VIP-LES/leos-efm-pcb/screenshots/3D.png

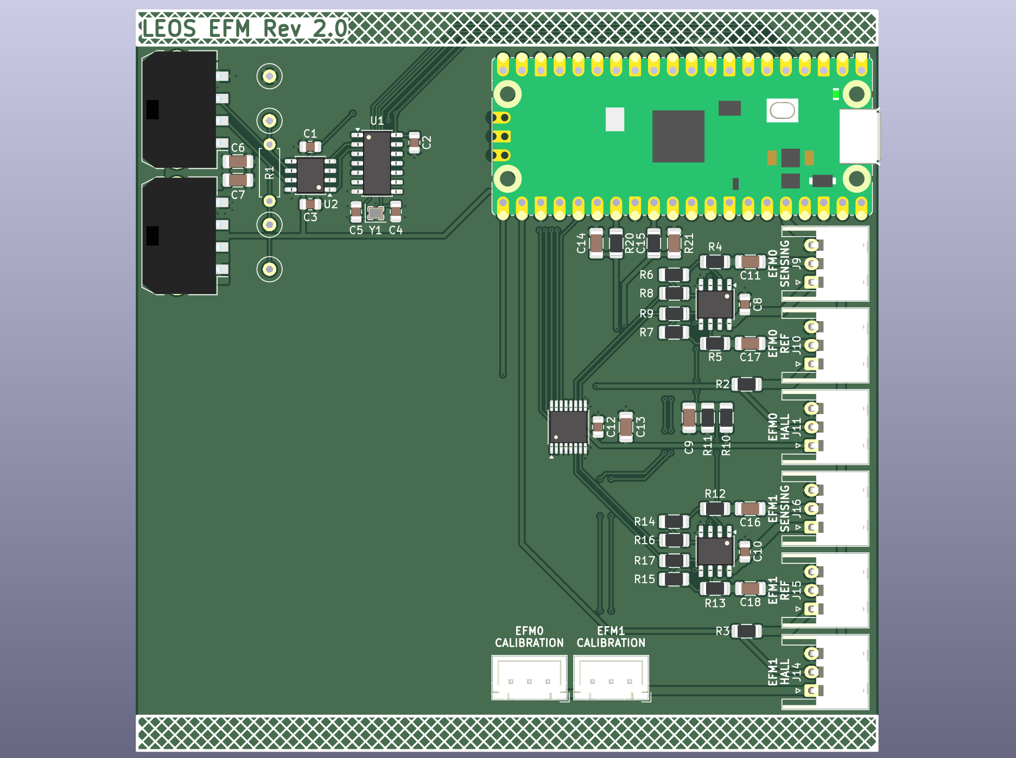
screenshots/3D.png
