VIP-LES/leos-efm-pcb/LEOS-efm.kicad_pcb

## KiCad design LEOS-efm.kicad_pcb (2026-10-29)

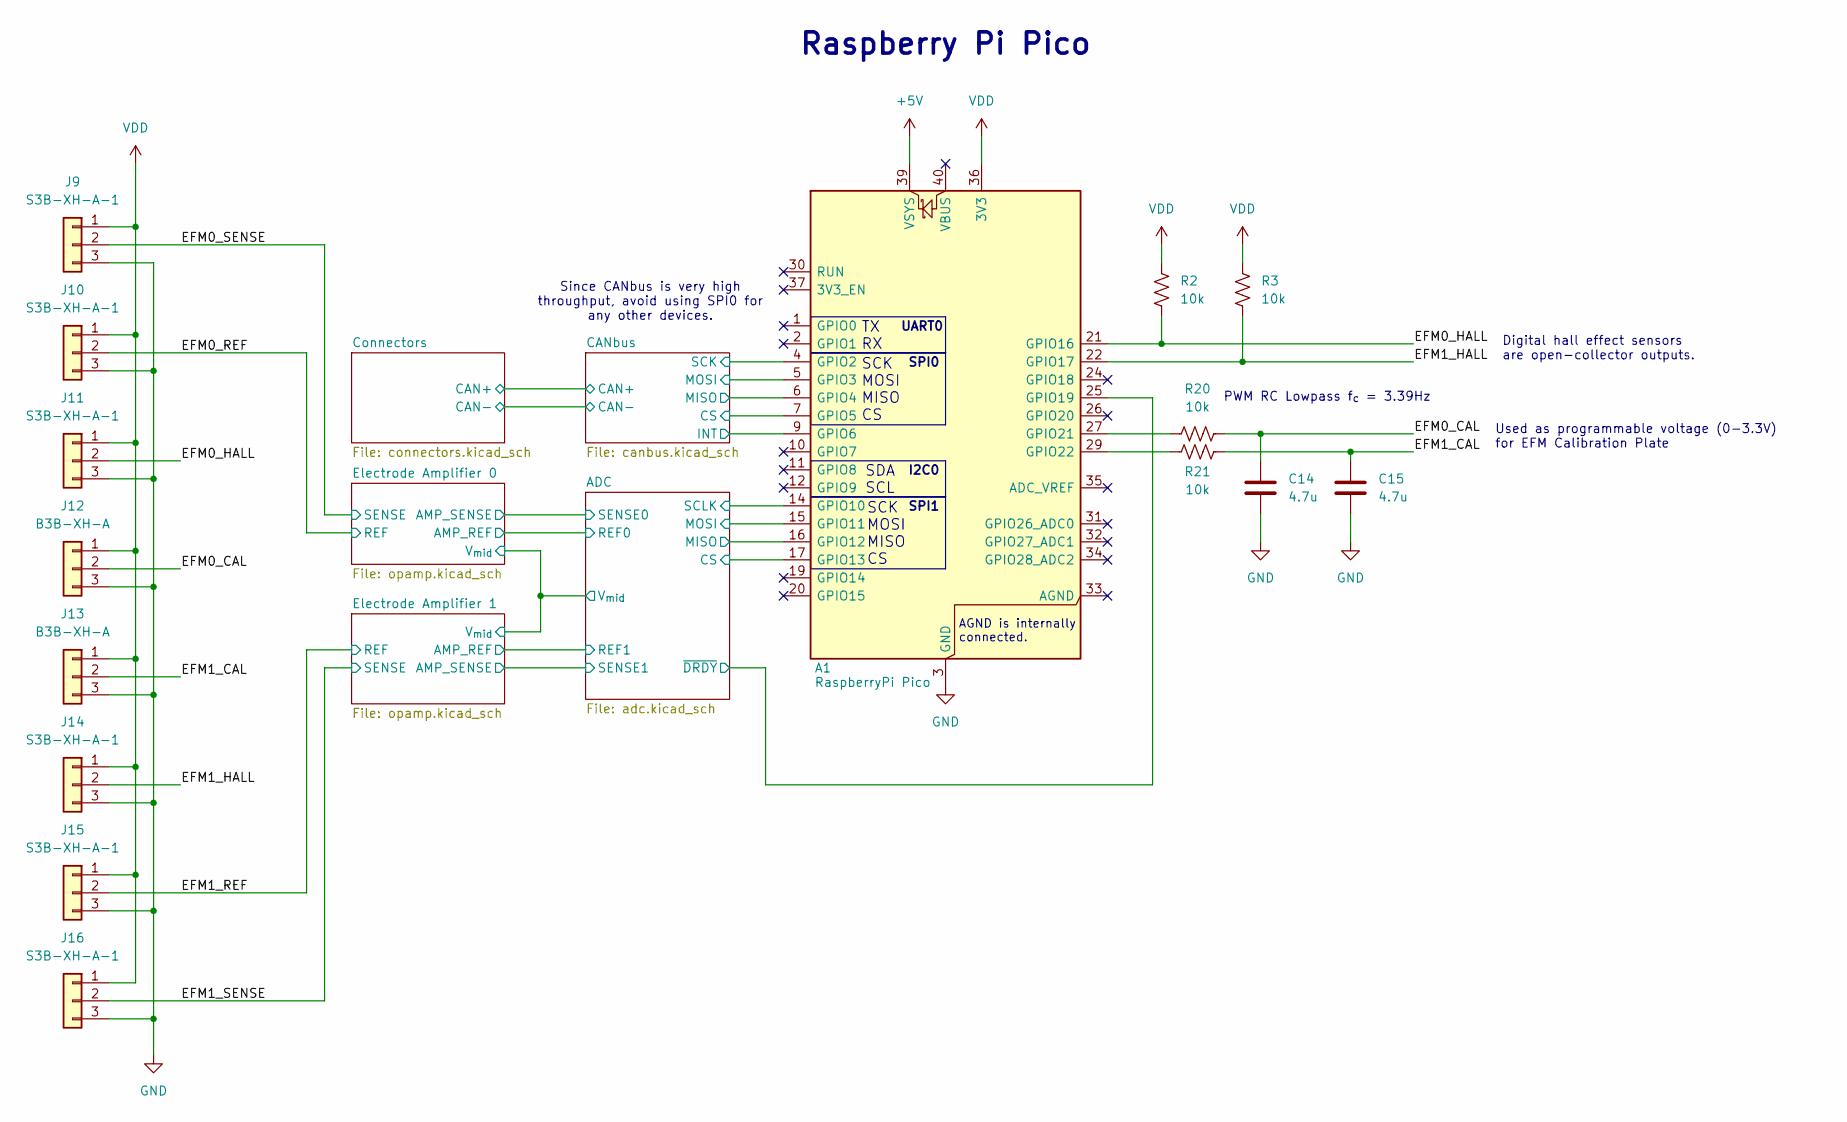
[picture p2: schematic LEOS-efm.kicad_sch, LEOS EFM]

Parts:
A1: RaspberryPi Pico; RaspberryPi_Pico_Common_Unspecified; MPN PIM724; Digikey 1778-PIM724-ND
C14, C15: 4.7u; C_1206_3216Metric; MPN CL31B475KBHNFNE; Digikey 1276-3179-1-ND
J9, J10, J11, J14, J15, J16: S3B-XH-A-1; JST_XH_S3B-XH-A-1_1x03_P2.50mm_Horizontal; MPN S3B-XH-A-1; Digikey 455-S3B-XH-A-1-ND
J12, J13: B3B-XH-A; JST_XH_B3B-XH-A_1x03_P2.50mm_Vertical; MPN B3B-XH-A; Digikey 455-2248-ND
R2, R3, R20, R21: 10k; R_1206_3216Metric

Connections:
+5V: A1.39 (VSYS); also elsewhere on the board
/ADC/CS: A1.17 (GPIO13); also elsewhere on the board
/ADC/MISO: A1.16 (GPIO12); also elsewhere on the board
/ADC/MOSI: A1.15 (GPIO11); also elsewhere on the board
/ADC/SCLK: A1.14 (GPIO10); also elsewhere on the board
/ADC/~DRDY: A1.25 (GPIO19); also elsewhere on the board
/CANbus/CS: A1.7 (GPIO5); also elsewhere on the board
/CANbus/INT: A1.9 (GPIO6); also elsewhere on the board
/CANbus/MISO: A1.6 (GPIO4); also elsewhere on the board
/CANbus/MOSI: A1.5 (GPIO3); also elsewhere on the board
/CANbus/SCK: A1.4 (GPIO2); also elsewhere on the board
/EFM0_CAL: C14.1, J12.2, R20.2
/EFM0_HALL: A1.21 (GPIO16), J11.2, R2.2
/EFM0_REF: J10.2; also elsewhere on the board
/EFM0_SENSE: J9.2; also elsewhere on the board
/EFM1_CAL: C15.1, J13.2, R21.2
/EFM1_HALL: A1.22 (GPIO17), J14.2, R3.2
/EFM1_REF: J15.2; also elsewhere on the board
/EFM1_SENSE: J16.2; also elsewhere on the board
GND: A1.3 (GND), A1.8 (GND), A1.13 (GND), A1.18 (GND), A1.23 (GND), A1.28 (GND), A1.38 (GND), C14.2, C15.2, J9.3, J10.3, J11.3, J12.3, J13.3, J14.3, J15.3, J16.3; also elsewhere on the board
unnamed: A1.27 (GPIO21), R20.1
unnamed: A1.29 (GPIO22), R21.1
VDD: A1.36 (3V3), J9.1, J10.1, J11.1, J12.1, J13.1, J14.1, J15.1, J16.1, R2.1, R3.1; also elsewhere on the board

Notes on the sheet:
PWM RC Lowpass f_{c} = 3.39Hz
SPI1
Raspberry Pi Pico
SCK MOSI MISO CS
Since CANbus is very high throughput, avoid using SPI0 for any other devices.
SPI0
SDA SCL
TX RX
UART0
Digital hall effect sensors are open-collector outputs.
I2C0
AGND is internally connected.
Used as programmable voltage (0-3.3V) for EFM Calibration Plate

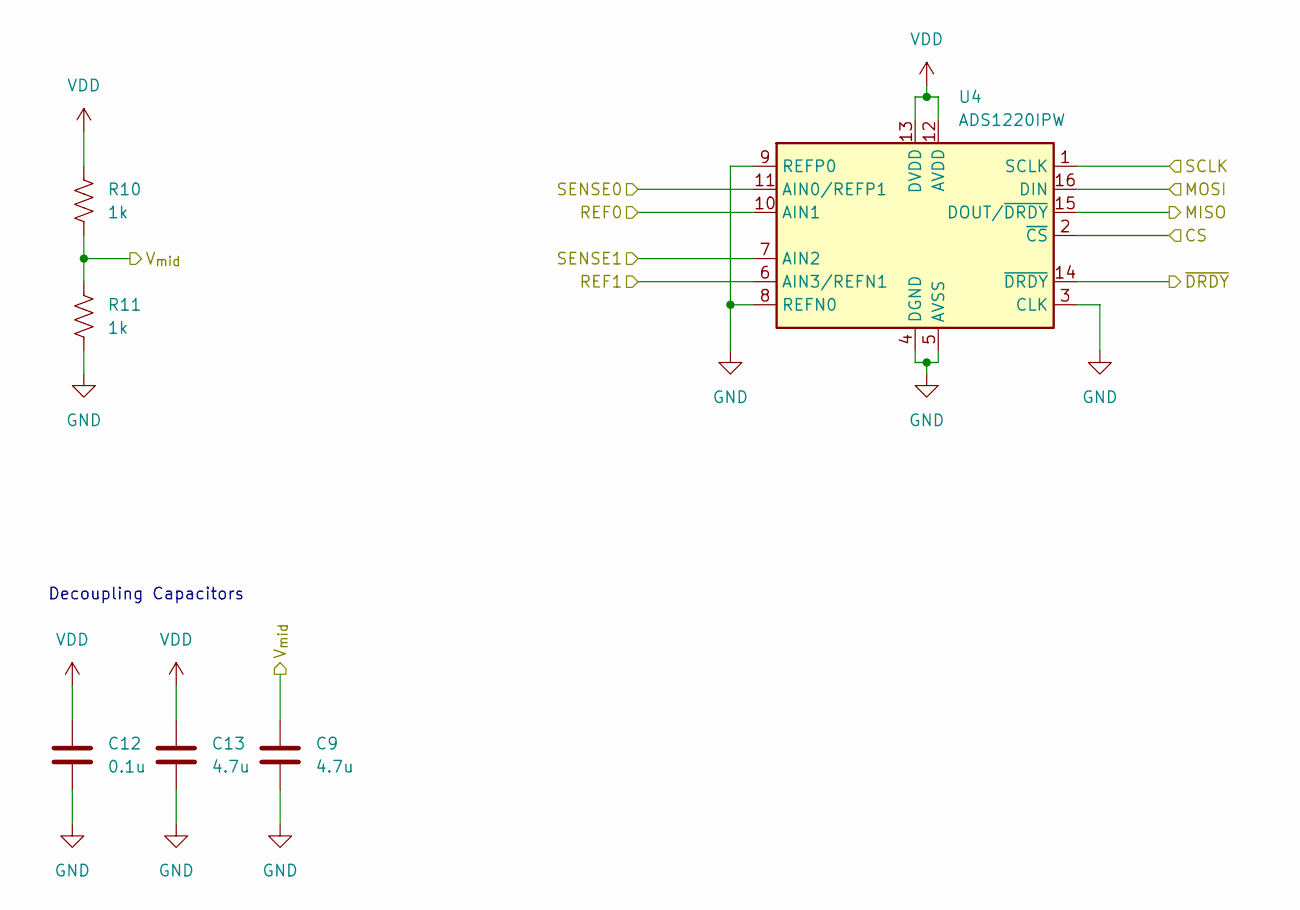
[picture p3: schematic adc.kicad_sch, Analog to Digital Conversion]

Parts:
C9, C13: 4.7u; C_1206_3216Metric; MPN CL31B475KBHNFNE; Digikey 1276-3179-1-ND
C12: 0.1u; C_0805_2012Metric; MPN CL21B104KBCNNNC; Digikey 1276-1003-1-ND
R10, R11: 1k; R_1206_3216Metric
U4: ADS1220IPW; TSSOP-16_4.4x5mm_P0.65mm; MPN ADS1220IPWR; Digikey 296-39851-1-ND

Connections:
/ADC/CS: U4.2 (~CS); also elsewhere on the board
/ADC/MISO: U4.15 (DOUT/~DRDY); also elsewhere on the board
/ADC/MOSI: U4.16 (DIN); also elsewhere on the board
/ADC/REF0: U4.10 (AIN1); also elsewhere on the board
/ADC/REF1: U4.6 (AIN3/REFN1); also elsewhere on the board
/ADC/SCLK: U4.1 (SCLK); also elsewhere on the board
/ADC/SENSE0: U4.11 (AIN0/REFP1); also elsewhere on the board
/ADC/SENSE1: U4.7 (AIN2); also elsewhere on the board
/ADC/V_{mid}: C9.1, R10.2, R11.1; also elsewhere on the board
/ADC/~DRDY: U4.14 (~DRDY); also elsewhere on the board
GND: C9.2, C12.2, C13.2, R11.2, U4.3 (CLK), U4.4 (DGND), U4.5 (AVSS), U4.8 (REFN0), U4.9 (REFP0); also elsewhere on the board
VDD: C12.1, C13.1, R10.1, U4.12 (AVDD), U4.13 (DVDD); also elsewhere on the board

Notes on the sheet:
Decoupling Capacitors

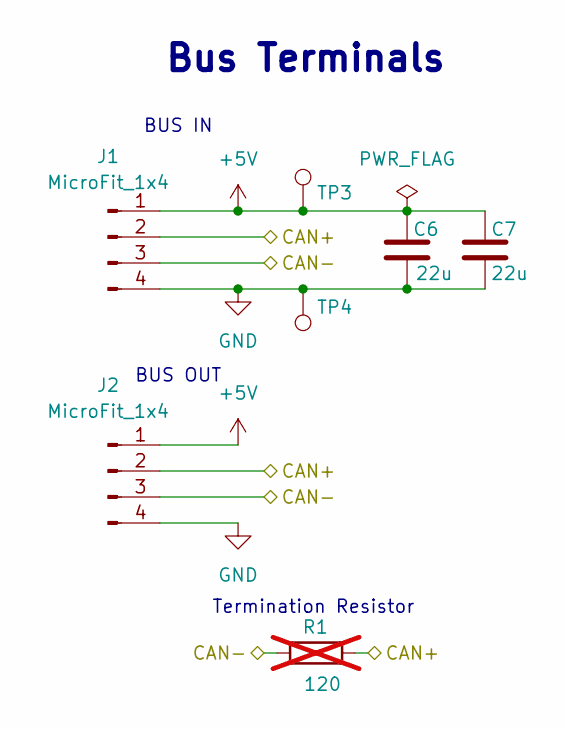
[picture p4: schematic connectors.kicad_sch, LEOS Connectors]

Parts:
C6, C7: 22u; C_1206_3216Metric; MPN CL31B226MPHNNNE; Digikey 1276-3148-1-ND
J1, J2: MicroFit_1x4; Molex_MicroFit3.0_43650-0410_1x04_Horizontal; MPN 0436500409; Digikey WM1882CT-ND
R1: 120; R_Axial_DIN0207_L6.3mm_D2.5mm_P7.62mm_Horizontal; MPN CF14JT120R; Digikey CF14JT120RCT-ND; not fitted
TP3: 5V Test Point; TestPoint_Loop_D2.60mm_Drill0.9mm_Beaded; MPN 5000; Digikey 36-5000-ND
TP4: GND Test Point; TestPoint_Loop_D2.60mm_Drill0.9mm_Beaded; MPN 5001; Digikey 36-5001-ND

Connections:
+5V: C6.1, C7.1, J1.1, J2.1, TP3.1 (1_1); also elsewhere on the board
/CANbus/CAN+: J1.2, J2.2, R1.2; also elsewhere on the board
/CANbus/CAN-: J1.3, J2.3, R1.1; also elsewhere on the board
GND: C6.2, C7.2, J1.4, J2.4, TP4.1 (1_1); also elsewhere on the board

Notes on the sheet:
BUS OUT
Bus Terminals
BUS IN
Termination Resistor

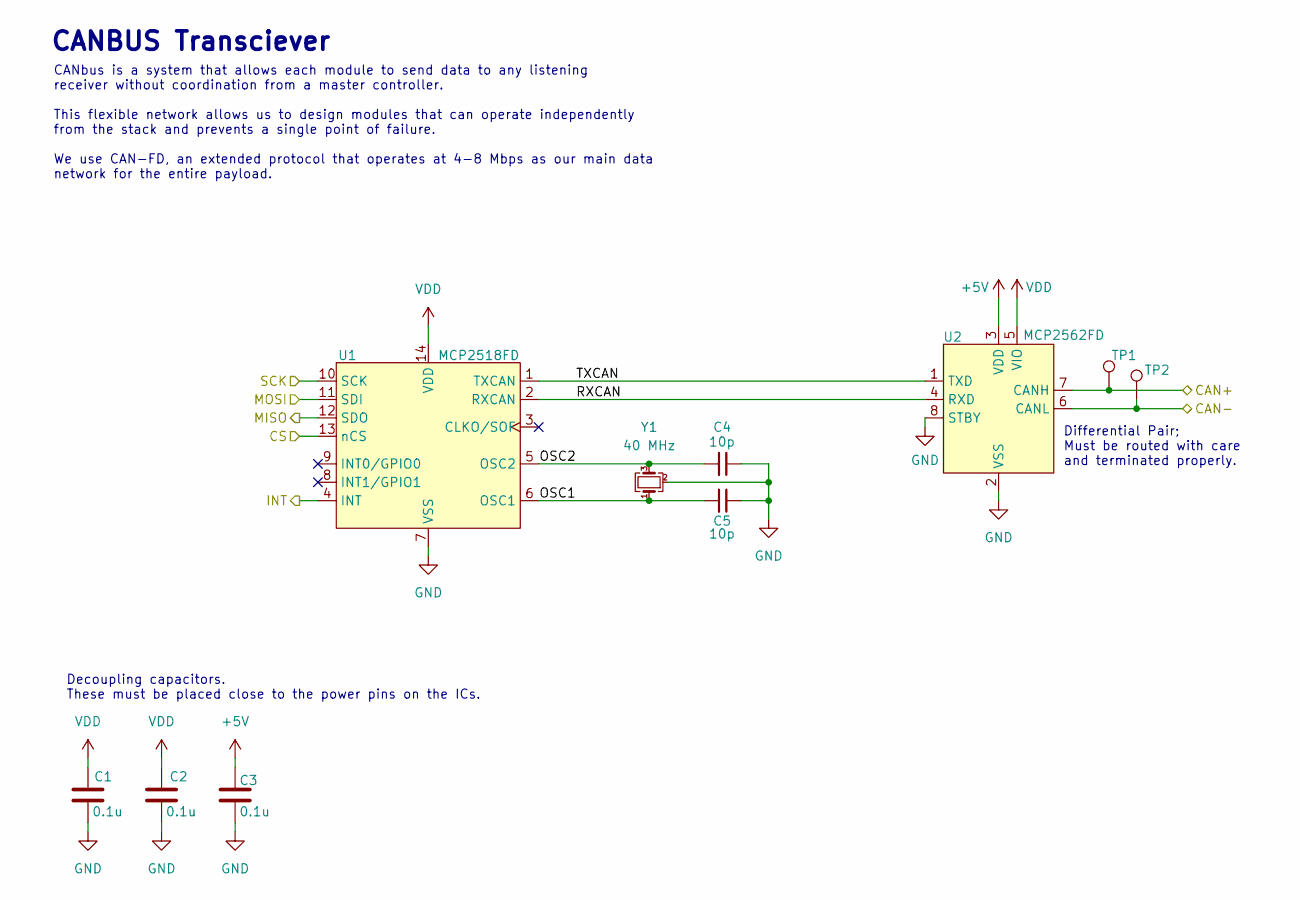
[picture p5: schematic canbus.kicad_sch, LEOS CANbus]

Parts:
C1, C2, C3: 0.1u; C_0805_2012Metric; MPN CL21B104KBCNNNC; Digikey 1276-1003-1-ND
C4, C5: 10p; C_0805_2012Metric; MPN CL21C100CBANNNC; Digikey 1276-2561-1-ND
TP1: CAN-H Test Point; TestPoint_Loop_D2.60mm_Drill0.9mm_Beaded; MPN 5004; Digikey 36-5004-ND
TP2: CAN-L Test Point; TestPoint_Loop_D2.60mm_Drill0.9mm_Beaded; MPN 5116; Digikey 36-5116-ND
U1: MCP2518FD; SOIC-14_3.9x8.7mm_P1.27mm; MPN MCP2518FDT-E/SL; LCSC C626758
U2: MCP2562FD; SOIC-8_3.9x4.9mm_P1.27mm; MPN MCP2562FDT-H/SN; LCSC C511335
Y1: 40 MHz; Crystal_SMD_2016-4Pin_2.0x1.6mm; MPN ECS-400-10-37B2-CKY-TR; Digikey 50-ECS-400-10-37B2-CKY-TRCT-ND

Connections:
+5V: C3.1, U2.3 (VDD); also elsewhere on the board
/CANbus/CAN+: TP1.1 (1_1), U2.7 (CANH); also elsewhere on the board
/CANbus/CAN-: TP2.1 (1_1), U2.6 (CANL); also elsewhere on the board
/CANbus/CS: U1.13 (nCS); also elsewhere on the board
/CANbus/INT: U1.4 (INT); also elsewhere on the board
/CANbus/MISO: U1.12 (SDO); also elsewhere on the board
/CANbus/MOSI: U1.11 (SDI); also elsewhere on the board
/CANbus/OSC1: C5.2, U1.6 (OSC1), Y1.1
/CANbus/OSC2: C4.2, U1.5 (OSC2), Y1.3
/CANbus/RXCAN: U1.2 (RXCAN), U2.4 (RXD)
/CANbus/SCK: U1.10 (SCK); also elsewhere on the board
/CANbus/TXCAN: U1.1 (TXCAN), U2.1 (TXD)
GND: C1.2, C2.2, C3.2, C4.1, C5.1, U1.7 (VSS), U2.2 (VSS), U2.8 (STBY), Y1.2 (G), Y1.4 (G); also elsewhere on the board
VDD: C1.1, C2.1, U1.14 (VDD), U2.5 (VIO); also elsewhere on the board

Notes on the sheet:
Differential Pair; Must be routed with care and terminated properly.
CANBUS Transciever
CANbus is a system that allows each module to send data to any listening receiver without coordination from a master controller. This flexible network allows us to design modules that can operate independently from the stack and prevents a single point of failure. We use CAN-FD, an extended protoco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
Decoupling capacitors. These must be placed close to the power pins on the ICs.

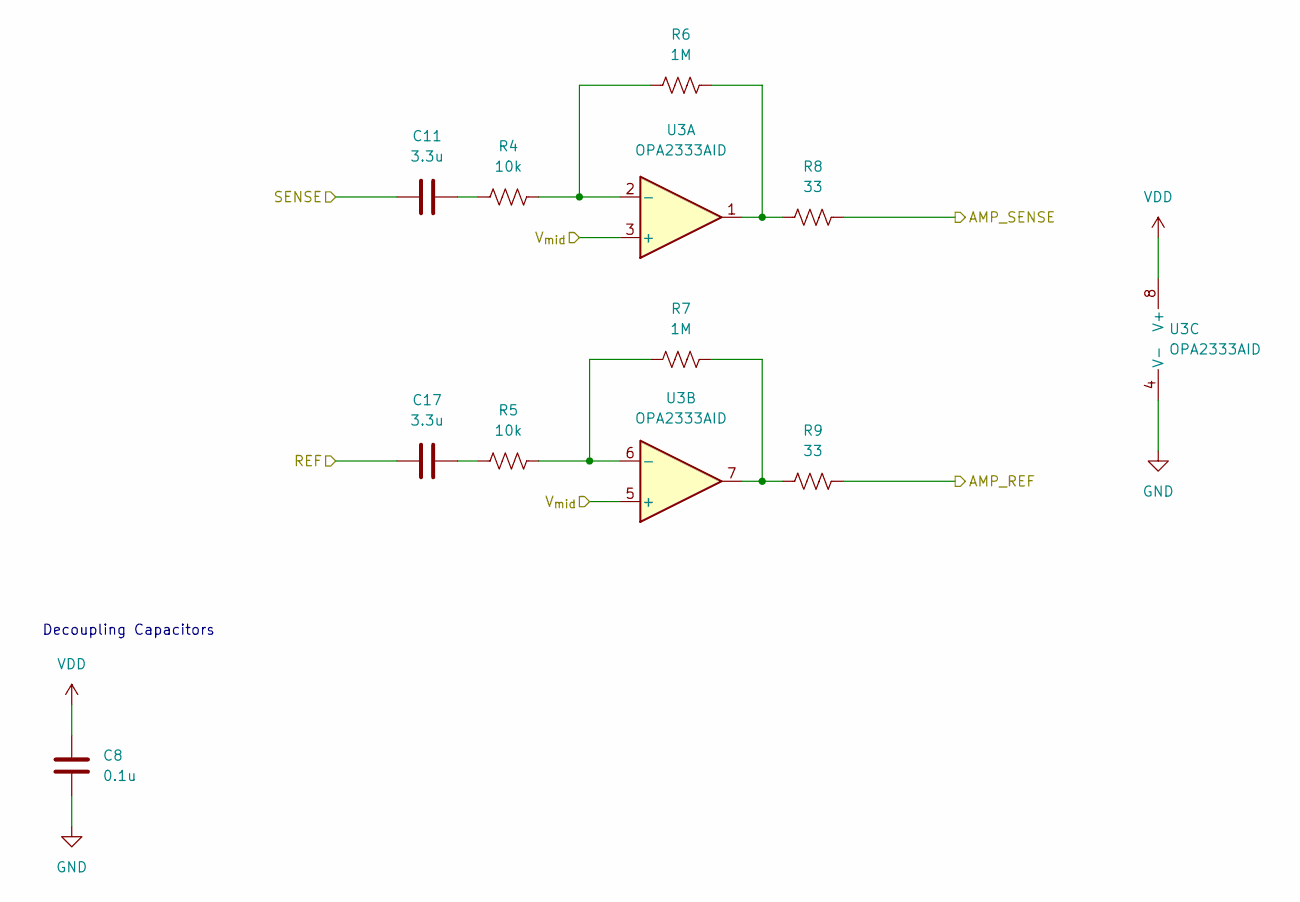
[picture p6: schematic opamp.kicad_sch, Electrode OpAmp]

Parts:
C8: 0.1u; C_0805_2012Metric; MPN CL21B104KBCNNNC; Digikey 1276-1003-1-ND
C11, C17: 3.3u; C_1206_3216Metric
R4, R5: 10k; R_1206_3216Metric
R6, R7: 1M; R_1206_3216Metric
R8, R9: 33; R_1206_3216Metric
U3: OPA2333AID; SOIC-8_3.9x4.9mm_P1.27mm; MPN OPA2333AID; Digikey 296-19543-5-ND

Connections:
/ADC/REF0: R9.2; also elsewhere on the board
/ADC/SENSE0: R8.2; also elsewhere on the board
/ADC/V_{mid}: U3.3 (+), U3.5 (+); also elsewhere on the board
/EFM0_REF: C17.1; also elsewhere on the board
/EFM0_SENSE: C11.1; also elsewhere on the board
GND: C8.2, U3.4 (V-); also elsewhere on the board
unnamed: C11.2, R4.1
unnamed: C17.2, R5.1
unnamed: R6.2, R8.1, U3.1
unnamed: R7.2, R9.1, U3.7
unnamed: R4.2, R6.1, U3.2 (-)
unnamed: R5.2, R7.1, U3.6 (-)
VDD: C8.1, U3.8 (V+); also elsewhere on the board

Parts of its further copies:
C10: 0.1u; C_0805_2012Metric; MPN CL21B104KBCNNNC; Digikey 1276-1003-1-ND
C16, C18: 3.3u; C_1206_3216Metric
R12, R13: 10k; R_1206_3216Metric
R14, R15: 1M; R_1206_3216Metric
R16, R17: 33; R_1206_3216Metric
U5: OPA2333AID; SOIC-8_3.9x4.9mm_P1.27mm; MPN OPA2333AID; Digikey 296-19543-5-ND

Connections of its further copies:
/ADC/REF1: R17.2; also elsewhere on the board
/ADC/SENSE1: R16.2; also elsewhere on the board
/ADC/V_{mid}: U5.3 (+), U5.5 (+); also elsewhere on the board
/EFM1_REF: C18.1; also elsewhere on the board
/EFM1_SENSE: C16.1; also elsewhere on the board
GND: C10.2, U5.4 (V-); also elsewhere on the board
unnamed: C16.2, R12.1
unnamed: C18.2, R13.1
unnamed: R14.2, R16.1, U5.1
unnamed: R15.2, R17.1, U5.7
unnamed: R12.2, R14.1, U5.2 (-)
unnamed: R13.2, R15.1, U5.6 (-)
VDD: C10.1, U5.8 (V+); also elsewhere on the board

Notes on the sheet:
Decoupling Capacitors

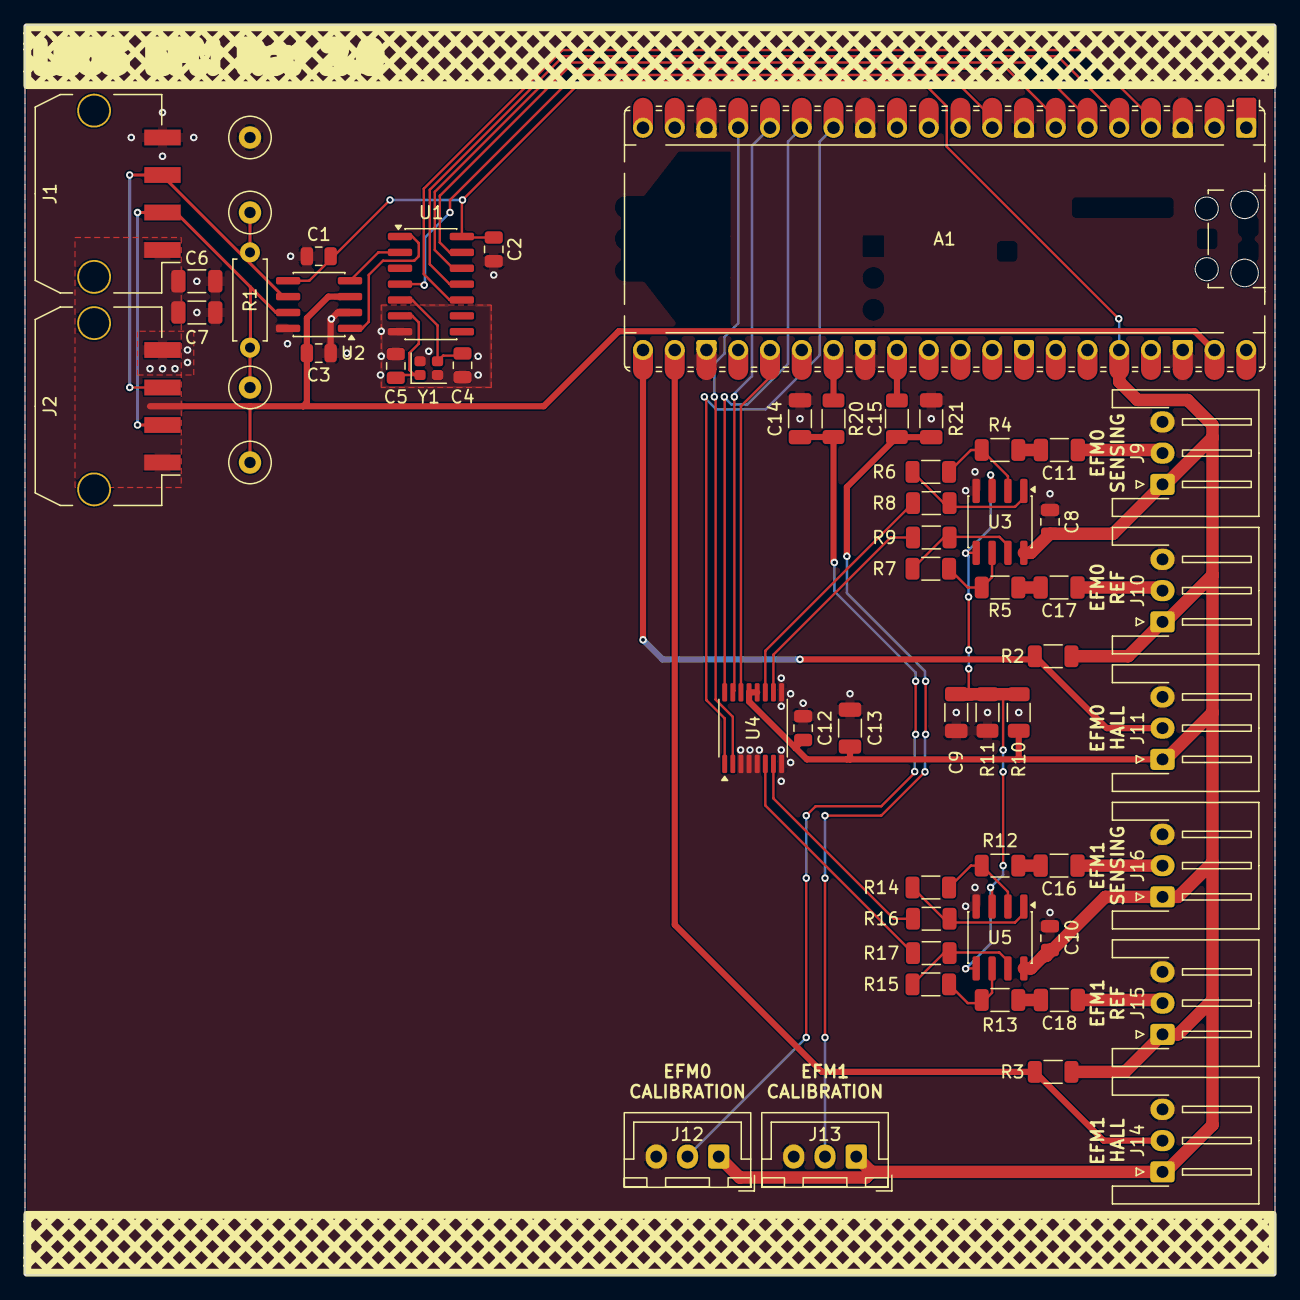
[picture p7: board LEOS-efm.kicad_pcb from above]

Board: 2 copper layers, 100.0 x 100.0 mm, 58 parts (0 on the bottom side), 46 nets.
