VIP-LES/leos-efm-pcb/(commit log)

2026-02-11 Set up EFM sheet with scattered op-amps
    [EFM.kicad_sch, LEOS-stack-template.kicad_sch]
2026-02-17 New blank
    [EFM.kicad_sch, LEOS-efm.kicad_pcb, LEOS-efm.kicad_sch, LEOS-stack-template.kicad_pcb, LEOS-stack-template.kicad_sch, canbus.kicad_sch, connectors.kicad_sch]
2026-10-13 Add two hall effect sensor circuit and two EFM opamp to differential ADC circuit
2026-10-29 Final Production Schematic/PCB Fall 2026
